weiweiweiopen/Teensy-4-galvos/img/laser_dye_3.jpg

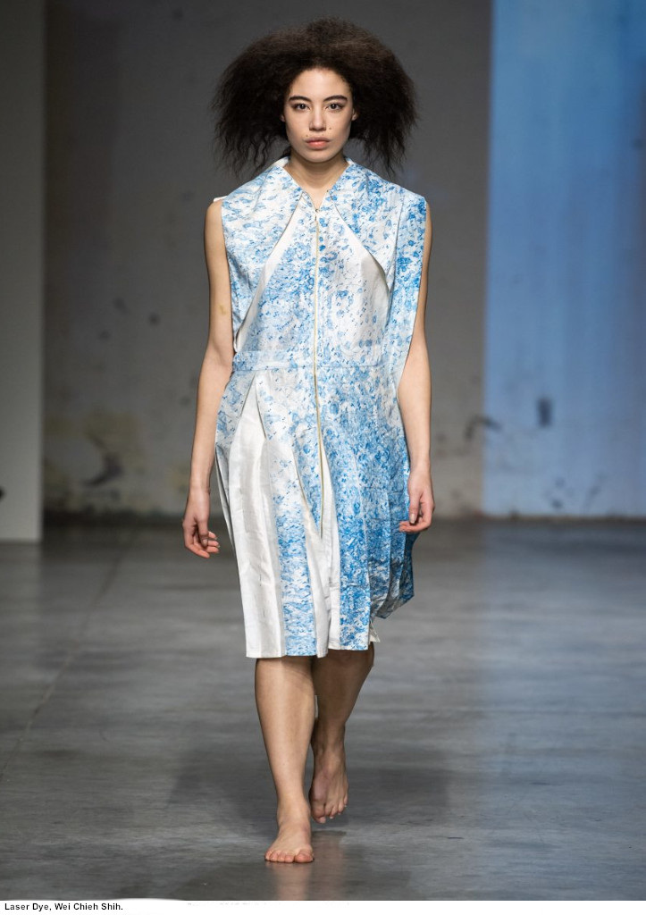
img/laser_dye_3.jpg
