weiweiweiopen/Teensy-4-galvos/img/laser_dye_2.jpg

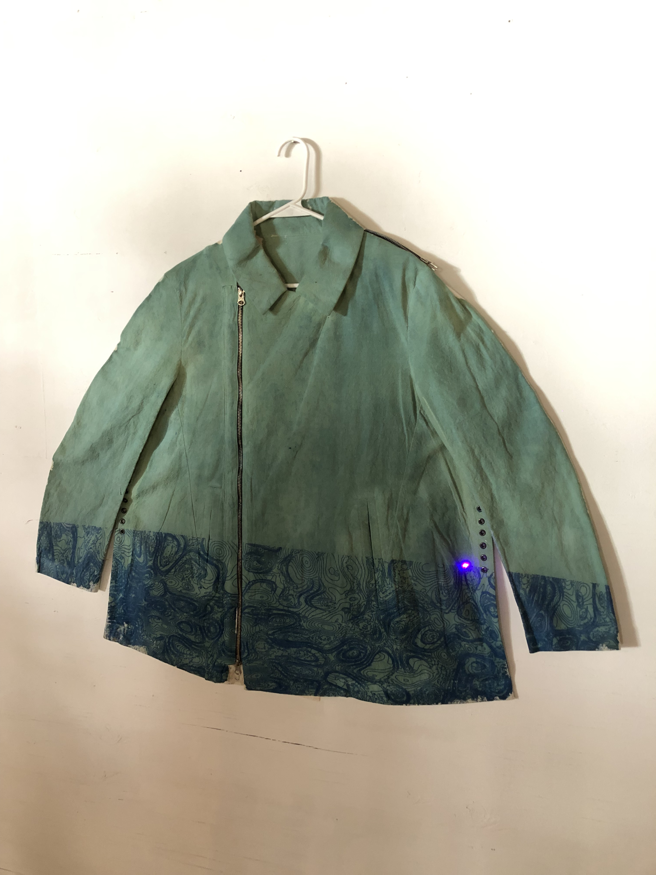
img/laser_dye_2.jpg
