weiweiweiopen/Teensy-4-galvos/hardwares/405 laser plate.png

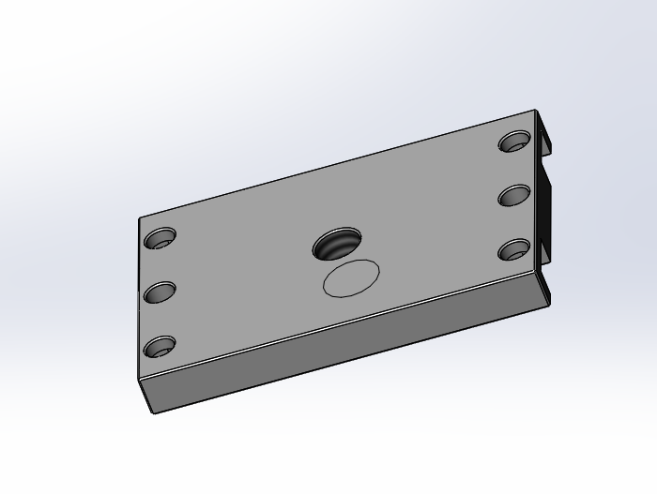
hardwares/405 laser plate.png
