weiweiweiopen/Teensy-4-galvos/hardwares/enclosure bottom plate.png

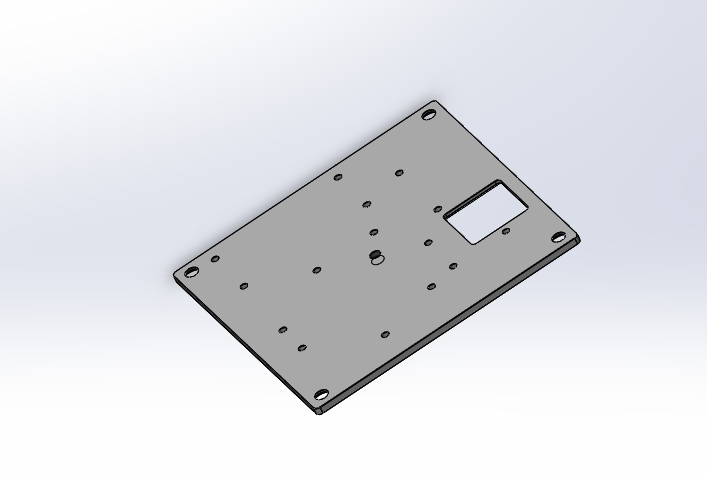
hardwares/enclosure bottom plate.png
