weiweiweiopen/Teensy-4-galvos/hardwares/enclosure upper plate.png

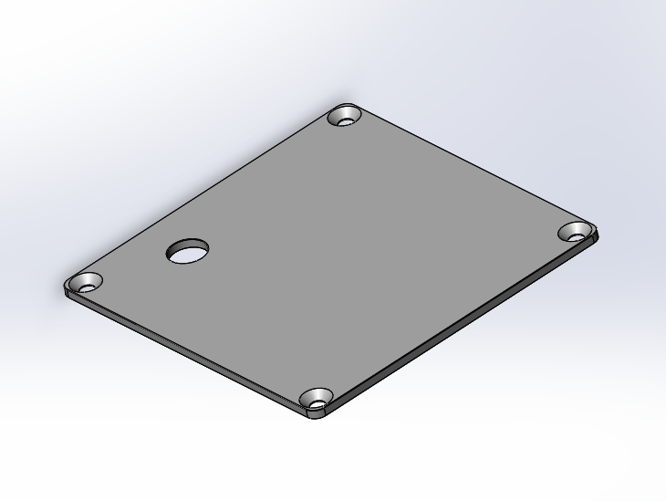
hardwares/enclosure upper plate.png
