weiweiweiopen/Teensy-4-galvos/hardwares/FreeCAD.png

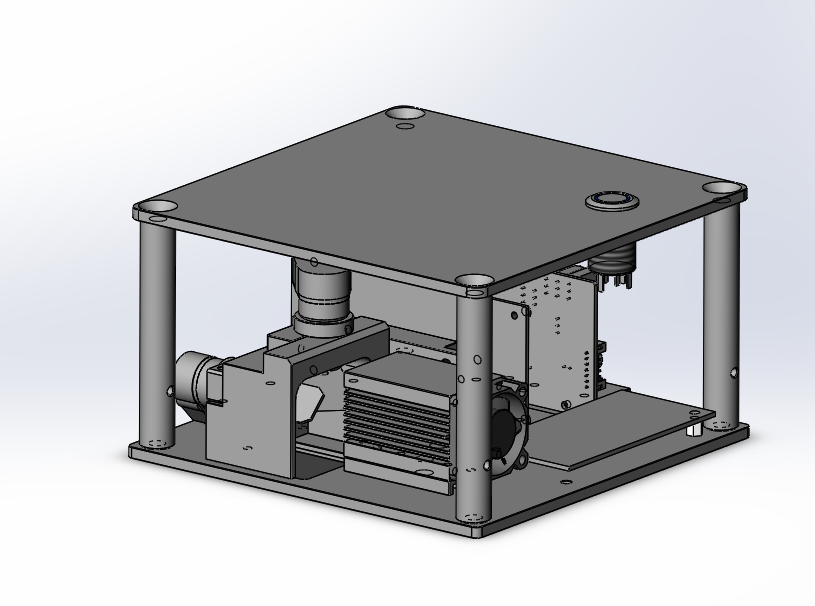
hardwares/FreeCAD.png
