weiweiweiopen/Teensy-4-galvos/img/laser_dye_1.jpg

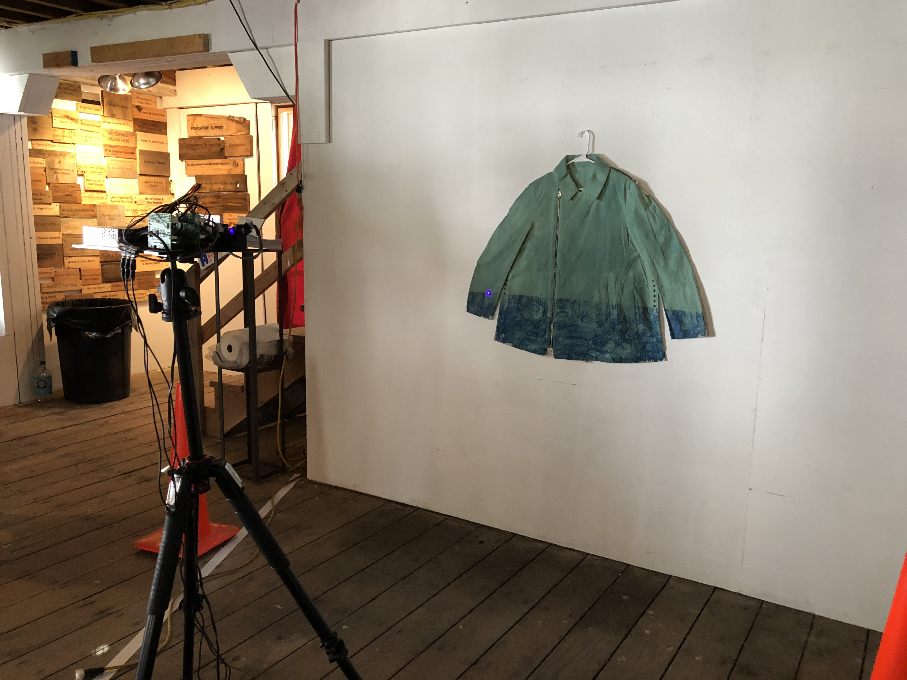
img/laser_dye_1.jpg
