weiweiweiopen/Teensy-4-galvos/img/MTML.jpg

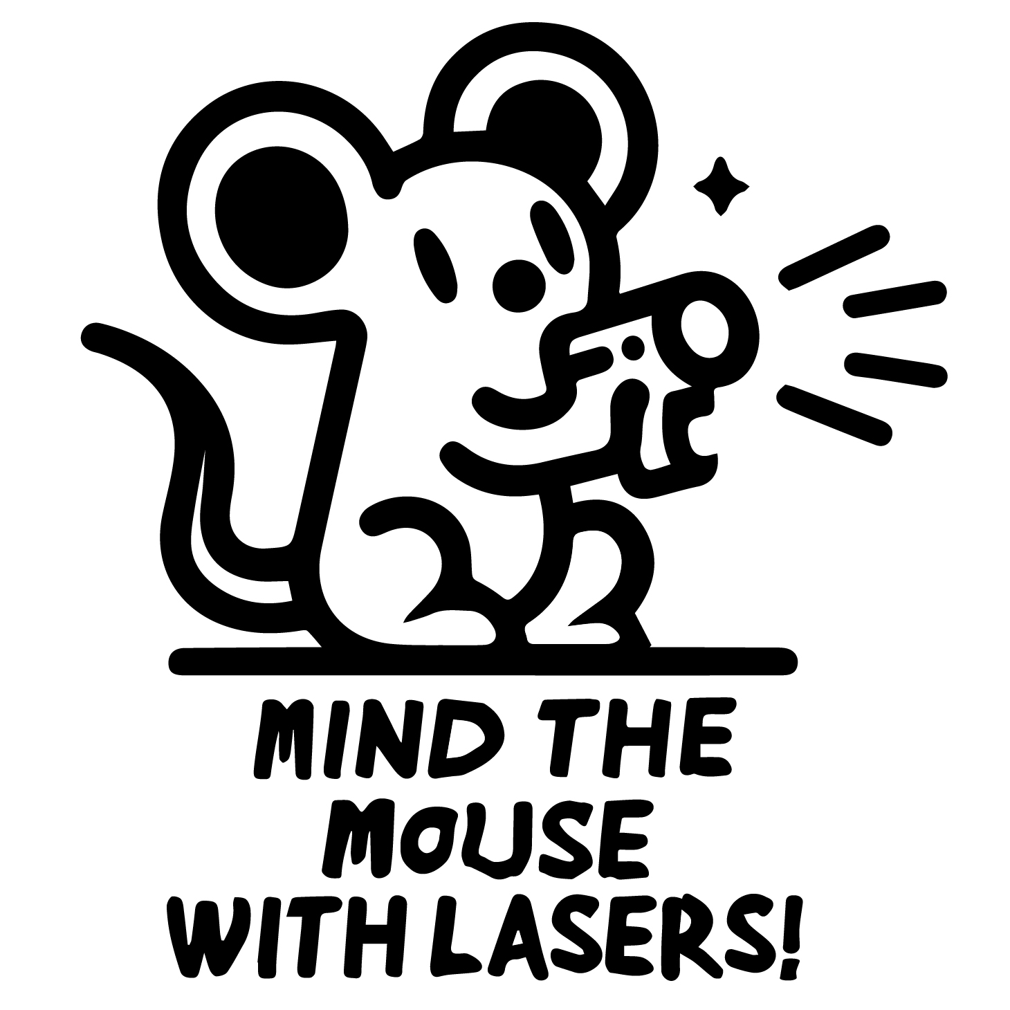
img/MTML.jpg
