weiweiweiopen/Teensy-4-galvos/hardwares/enclosure bottom plate.pdf

2 32

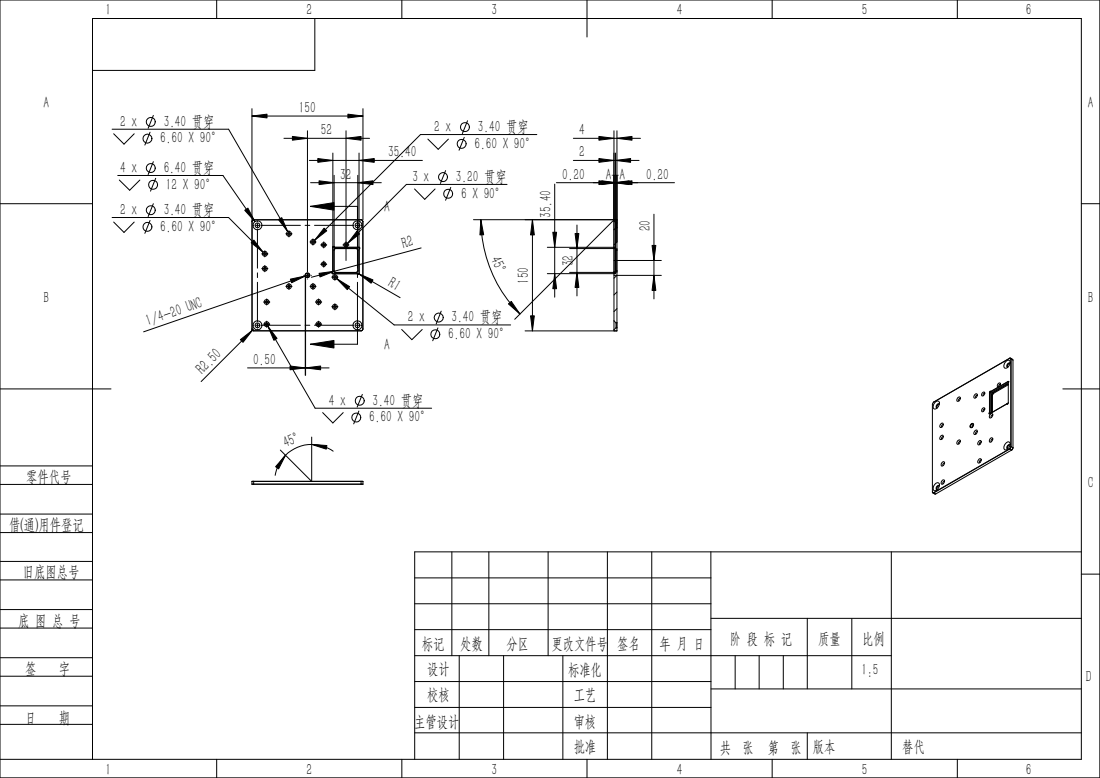
[picture p11: page 1]
1/4-20 UNC; 标准化; 主管设计; 零件代号; 借(通)用件登记; 旧底图总号

标记 | 处数 | 分区 | 更改文件号 | 签名 | 年 月 日
