weiweiweiopen/Teensy-4-galvos/kicad/teensy-4-galvos.kicad_pcb

## KiCad design kicad/teensy-4-galvos.kicad_pcb (2026-10-13)

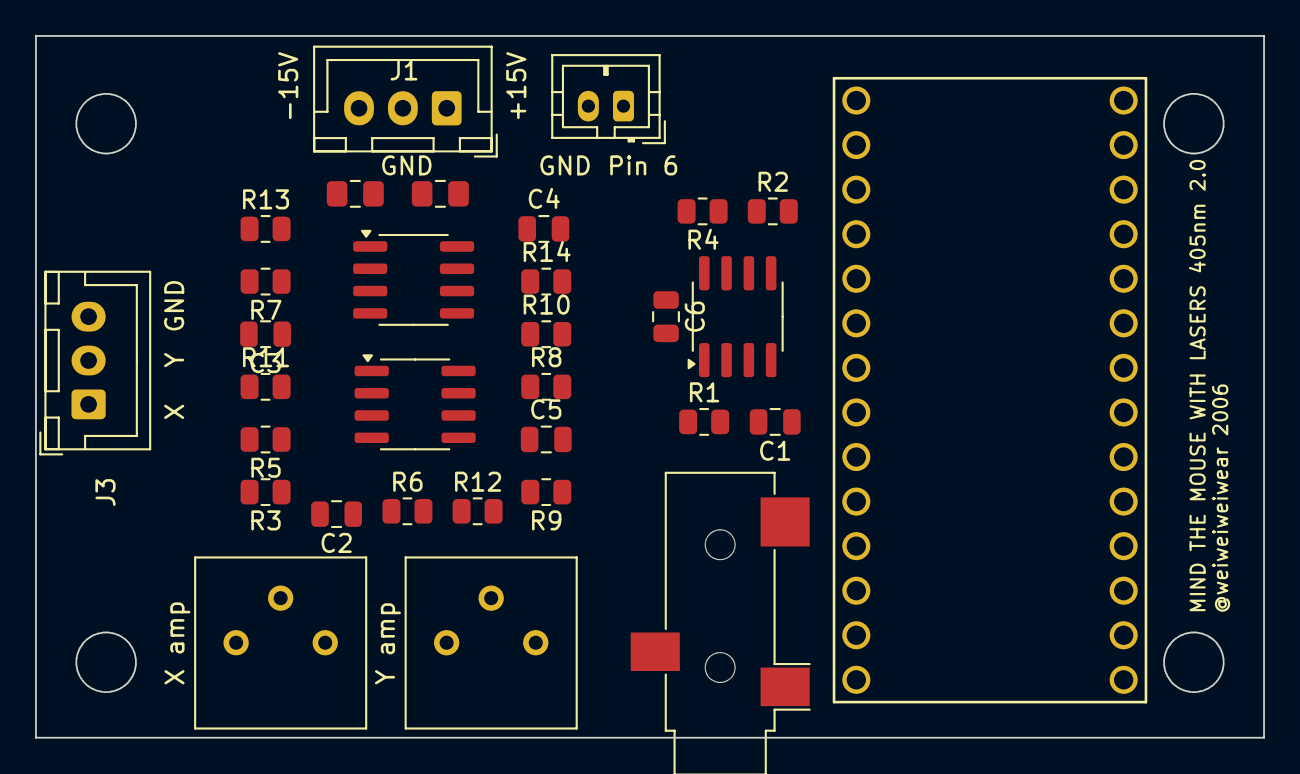
[picture p13: board teensy-4-galvos.kicad_pcb from above]

Board: 2 copper layers, 70.0 x 40.0 mm, 32 parts (0 on the bottom side), 22 nets, no tracks yet.

Parts:
C1, C2, C3, C4, C5, C6: 0.1uF; C_0805_2012Metric
C7, C8: 10uF; C_0805_2012Metric_Pad1.18x1.45mm_HandSolder
J1, J3: +15 G -15; JST_XH_B3B-XH-A_1x03_P2.50mm_Vertical
J2: AudioJack3_SwitchTR; Jack_3.5mm_CUI_SJ-3523-SMT_Horizontal
J7: 405nm; JST_PH_B2B-PH-K_1x02_P2.00mm_Vertical
R1, R2, R5, R7: 1k; R_0805_2012Metric
R3, R4, R11, R12, R13, R14: 330; R_0805_2012Metric
R6, R8, R9, R10: 22k; R_0805_2012Metric
U1: TL072; SOIC-8_3.9x4.9mm_P1.27mm
U2: X galvo; SOIC-8_3.9x4.9mm_P1.27mm
U3: Y TL072; SOIC-8_3.9x4.9mm_P1.27mm
U4: Teensy4.0; Teensy40
X amp: 10k; Potentiometer_Bourns_3386P_Vertical
Y amp: 10k; Potentiometer_Bourns_3386P_Vertical

Connections:
+15V: C4.1, C5.1, C6.1, C8.1, J1.1, U1.8 (V+), U2.8 (V+), U3.8 (V+)
-15V: C1.1, C2.1, C3.1, C7.1, J1.3, U1.4 (V-), U2.4 (V-), U3.4 (V-)
/laser en: J7.1, U4.8 (6_OUT1D)
Ax_Ring_OUT: J2.R, U1.5 (+)
Ax_Tip_OUT: J2.T, U1.3 (+)
GND: C1.2, C2.2, C3.2, C4.2, C5.2, C6.2, C7.2, C8.2, J1.2, J3.3, J7.2, R1.1, R2.1, U2.5 (+), U3.5 (+)
unnamed: J3.1, R12.1
unnamed: J3.2, R14.1
unnamed: R3.1, R5.2, R6.2, U1.1
unnamed: R3.2, X amp.2
unnamed: R4.1, R7.2, R8.2, U1.7
unnamed: R4.2, Y amp.2
unnamed: R10.1, R14.2, U3.7
unnamed: R9.1, R12.2, U2.7
unnamed: R1.2, U1.2 (-), X amp.1
unnamed: R2.2, U1.6 (-), Y amp.1
unnamed: R5.1, U2.3 (+)
unnamed: R11.2, U2.1, U2.2 (-)
unnamed: R6.1, R9.2, U2.6 (-)
unnamed: R7.1, U3.3 (+)
unnamed: R13.2, U3.1, U3.2 (-)
unnamed: R8.1, R10.2, U3.6 (-)
