weiweiweiopen/Teensy-4-galvos/(commit log)

2025-09-14 Initial import: Teensy-4-galvos project; add FreeCAD image to README
    [TL072.kicad_sch, power.kicad_sch, teensy-4-galvos.kicad_pcb, teensy-4-galvos.kicad_sch]
2025-12-26 Add files via upload
    fixed the laser on/off problem while switching mode
2026-02-11 Change laserPin from 5 to 6
2026-03-15 Add Teensy galvo project with Python stippling tools
    [TL072.kicad_sch, power.kicad_sch, teensy-4-galvos.kicad_pcb, teensy-4-galvos.kicad_sch]
2026-03-26 Change Teensy version from 4.1 to 4.0
    Updated references from Teensy 4.1 to Teensy 4.0 in the README.
2026-06-06 Update KiCad source files
    [TL072.kicad_sch, teensy-4-galvos.kicad_pcb, teensy-4-galvos.kicad_sch]
2026-06-08 Update KiCad board files
    [TL072.kicad_sch, teensy-4-galvos.kicad_pcb, teensy-4-galvos.kicad_sch]
